snckwf/usb-game-controller-raspberry-pico-recalbox/images/controller-pico-inside.png

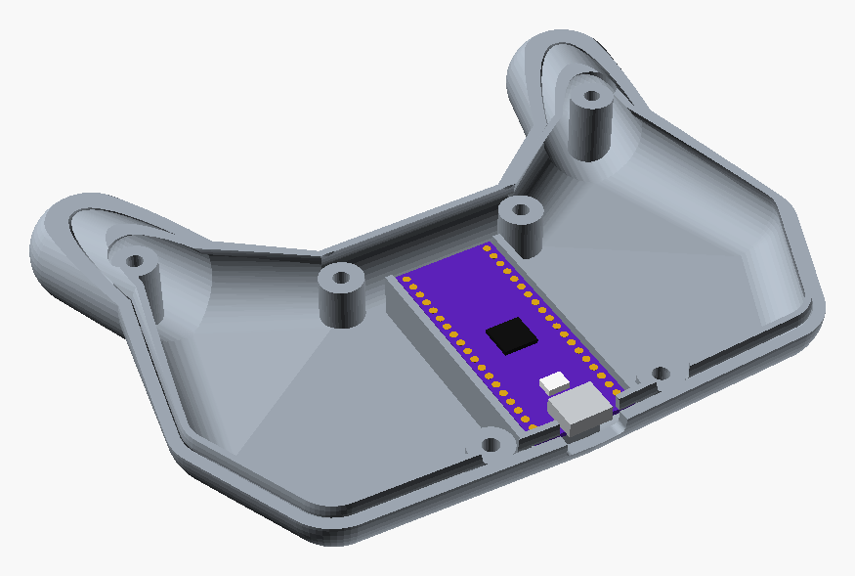
images/controller-pico-inside.png
