snckwf/usb-game-controller-raspberry-pico-recalbox/images/cover-usb-controller-pico.png

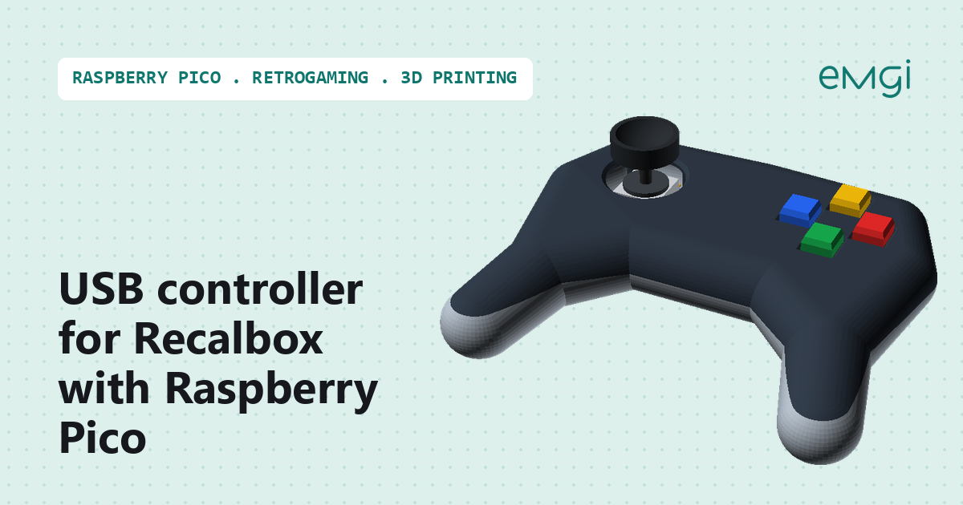
images/cover-usb-controller-pico.png
