snckwf/usb-game-controller-raspberry-pico-recalbox/images/controller-pico-parts.png

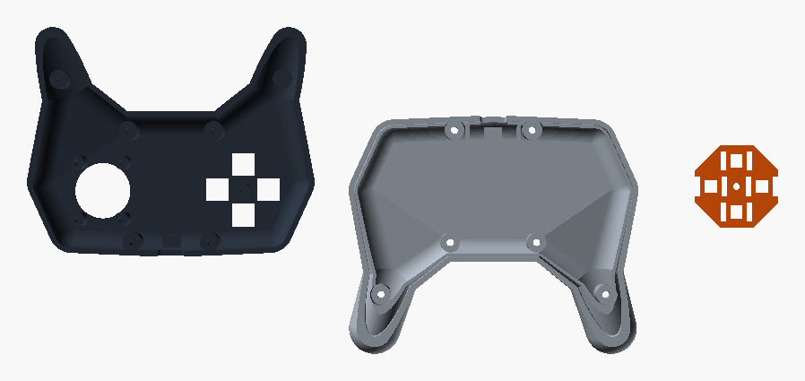
images/controller-pico-parts.png
