snckwf/usb-game-controller-raspberry-pico-recalbox/stl/controller_pico_button_plate.stl

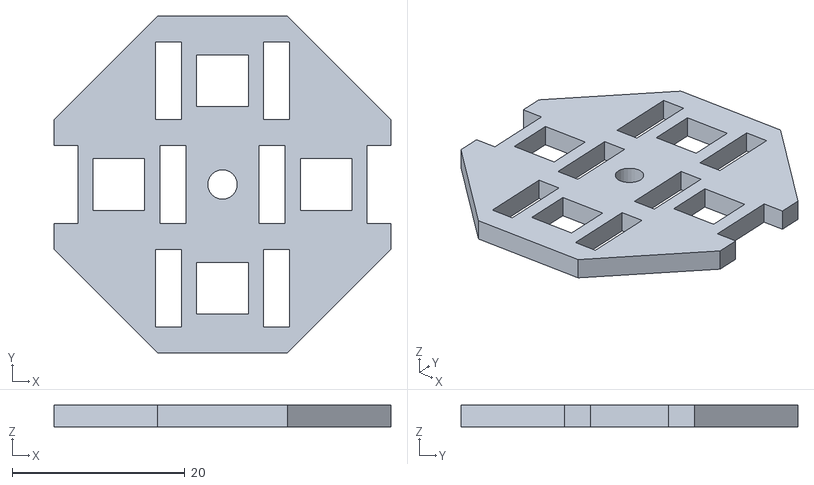
[picture p8: CAD file, 2026-10-28]
stl/controller_pico_button_plate.stl
39.0 x 39.0 x 2.50
