snckwf/usb-game-controller-raspberry-pico-recalbox/stl/controller_pico_top.stl

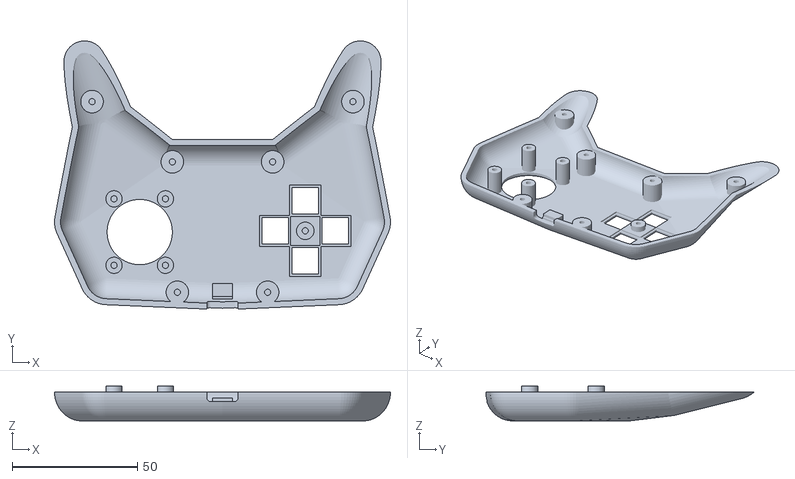
[picture p9: CAD file, 2026-10-28]
stl/controller_pico_top.stl
134.0 x 106.9 x 13.9
