snckwf/usb-game-controller-raspberry-pico-recalbox/stl/controller_pico_bottom.stl

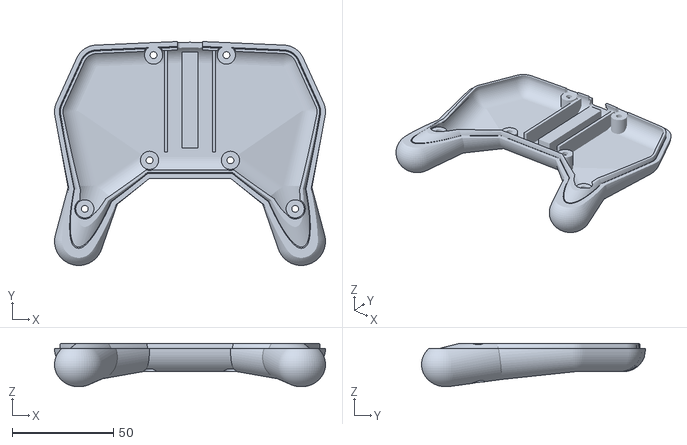
[picture p10: CAD file, 2026-10-28]
stl/controller_pico_bottom.stl
134.0 x 110.7 x 21.5
