snckwf/usb-game-controller-raspberry-pico-recalbox/docs/assembly_guide.html

Assembly and wiring guide

# Slim USB controller with Raspberry Pico

A KY-023 joystick on the left, four 12×12 buttons on the right and a Raspberry Pi Pico inside a slim 23 mm shell, with the long grips of 90s gamepads. It connects with a USB cable and is recognised as a standard gamepad by PCs, Recalbox, RetroPie, Batocera and Android, without drivers.

Assembled controller

Controller seen from the side: slim body

## Bill of materials

### Electronics

Qty | Component | Notes
1 | Raspberry Pi Pico RP2040, TZT clone with USB-C | 21 × 51 mm, 40 pins like the original Pico, no headers soldered. The original Pico with micro-USB also works
1 | KY-023 analogue joystick module | With the stick cap
4 | 12×12×7.3 tactile button with 10×10 square cap | Green, red, blue and yellow caps
1 | USB-C data cable (not charge-only) | USB-A → USB-C for the Recalbox Raspberry Pi and for the PC; 1.5–2 m long

### Screws

Qty | Component | Where
4 | M3×12 cheese-head screw | Closing the body, from below (two at the back, two at the front)
2 | M3×8 cheese-head screw | Closing in the grips, from below
4 | M3×6 button-head screw | Joystick
1 | M3×6 button-head screw | Button plate

### Consumables

Qty | Material | Notes
~90 g | PLA or PETG filament | Three printed parts, supports included
~1.5 m | 0.14–0.25 mm² flexible wire | Ideally in 7 colours (see the wiring table)
~10 cm | 1.5–2 mm heat-shrink tubing | On the joystick solder joints
— | Solder, hot glue (optional) | The glue holds the wires and the Pico in its cradle

### Tools

Fine-tip soldering iron, wire stripper, side cutters | Phillips screwdriver or hex key for the M3 screws
2.5 mm drill bit to clean up the pilot holes | Cutter or deburring tool for the supports

## Printed parts

The three parts in print orientation

From the left: top shell (upside down, as it goes on the bed), bottom shell, button plate.

Part | File | Orientation | Supports
Top shell | controller_pico_top.stl | Upside down, control face on the bed (already oriented in the file) | Tree supports, from the bed only, under the grips
Bottom shell | controller_pico_bottom.stl | As is, opening facing up | Tree supports, from the bed only: it rests on the tips of the grips
Button plate | controller_pico_button_plate.stl | Flat | None

PLA or PETG, 0.2 mm layers, 3 perimeters, 20% infill. Footprint 134 × 111 mm, 23 mm thick in the middle and 33 mm at the grip tips: it fits all Kobra printers and the i3 Mega S. Before printing, measure the hole spacing of your KY-023 (joy_fori, 20.5 × 26.5), the height of the metal bracket (joy_alt, 11.5), the thickness of the Pico board (pm_sp, 1.0) and the height of the USB-C socket (usb_h, 3.2), and correct the parameters in controller_pico.scad if needed.

## Wiring

Wiring diagram. Orange = 3.3 V, black = GND, the other colours are signals, the same as in the table below.

Component | Pin | Pico | Suggested wire
KY-023 joystick | GND | AGND (pin 33) | black
| +5V | 3V3(OUT) (pin 36) | orange
| VRx | GP26 (pin 31) | olive green
| VRy | GP27 (pin 32) | teal
| SW (click = L3 / FUNCTION) | GP6 (pin 9) | purple
Button A (bottom) | pin 1 | GP2 (pin 4) | green
Button B (right) | pin 1 | GP3 (pin 5) | red
Button X (left) | pin 1 | GP4 (pin 6) | blue
Button Y (top) | pin 1 | GP5 (pin 7) | yellow
4 buttons | pin 4 | GND (pin 38 or another GND) | black, one wire daisy-chained from button to button

The joystick pin marked +5V must go to the Pico's 3V3(OUT), not to VBUS or VSYS: with 5 V the VRx/VRy outputs exceed the 3.3 V the inputs can handle.

Pin numbers count from 1 (top left, next to the USB socket) going down the left side to 20, then back up the right side from 21 to 40. The joystick goes to the analogue ground AGND (pin 33) for less noise on the axes; the buttons to any GND (pins 3, 8, 13, 18, 23, 28, 38).

On 12×12 buttons the pins on the same side are already connected together: if a button always reads as pressed, you used two pins on the same side. Always take two diagonally opposite pins (1 and 4).

## Steps

The three parts fresh off the printer

STEP 1

### Prepare the parts

cutter2.5 mm drill bit

1. Remove the supports from the grips and clean the centring lip of the bottom shell.
2. Clean up the post pilot holes with the 2.5 mm bit (joystick, plate and the 6 closing posts).
3. Dry fit: the button caps must slide in the square holes without forcing, and the two shells must close without steps.

Joystick mounted under the top shell

Top shell upside down: the board rests on the 4 posts

STEP 2

### Solder the wires and mount the joystick

KY-0234 × M3×65 wires, 15 cm

1. Solder 5 wires, 15 cm long, to the joystick, directly onto the 90° pins (shorten them to 3–4 mm): Dupont connectors do not fit. Slide heat-shrink over each joint.
2. Place the top shell upside down on the bench. Push the stick through the 26 mm hole on the left and rest the board on the 4 posts, with the connector towards the back.
3. Drive in the M3×6 screws without overtightening: the plastic taps itself.
4. Move the stick in every direction: it must not touch the edge of the hole.

Buttons and plate mounted

Buttons in their seats, orange plate on top, screw in the middle

STEP 3

### Buttons and plate

4 buttons 12×12plate1 × M3×6

1. Fit the caps on the buttons: yellow Y at the top, red B on the right, blue X on the left, green A at the bottom.
2. Solder the signal wire to pin 1 of each button and the ground chain to pin 4 (diagonally opposite).
3. Insert the buttons from the inside: the cap comes out of the square hole, the body goes into the 12.4 mm seat.
4. Lay the plate on top: its legs go into the slots and the wires come out of the central holes.
5. Fix it with the M3×6 screw in the central post and check that all 4 buttons click.

Pico in the cradle of the bottom shell

The Pico in its cradle, USB-C socket in the rear window

STEP 4

### Upload the firmware and mount the Pico

Arduino IDERaspberry Pi PicoBOOTSEL

1. In the Boards Manager install Raspberry Pi Pico/RP2040/RP2350 by Earle F. Philhower. No libraries needed: the USB gamepad is included.
2. Before soldering, hold the Pico's BOOTSEL button while plugging in the cable: it shows up as the RPI-RP2 drive.
3. Open controller_pico.ino, choose the Raspberry Pi Pico board and UF2_Board as the port, then Upload.
4. Place the Pico in the cradle of the bottom shell, components facing up, with the USB-C socket in the rear window.
5. Solder the wires into the pin holes from the component side, following the wiring table. Leave them long enough to open the shells like a book.
6. Optional: a dab of hot glue at the bottom of the cradle. The socket is held anyway by the tooth on the top shell.

Later uploads do not need BOOTSEL: the IDE resets the Pico by itself over the USB port, even with the controller closed.

STEP 5

### Test with the shells open

joy.cplserial monitor

1. Plug in the USB cable without touching the stick: at start-up the firmware measures the joystick centre and the Pico LED blinks twice. The LED lights up while you press a button.
2. On Windows press Win+R, type joy.cpl and open the controller Properties: check the 2 axes, the d-pad (POV) and the buttons.
3. If an axis is reversed or swapped, change INVERT_X, INVERT_Y or SWAP_XY at the top of the sketch and upload again.
4. To see the raw values open the serial monitor and send d.

Closing the two shells

The top shell drops onto the lip, the 6 screws go in from below

STEP 6

### Close the controller

4 × M3×122 × M3×8

1. Route the wires away from the stick and the plate: no wire must lie under the joystick board.
2. Rest the top shell on the centring lip of the bottom shell.
3. From below, drive the 4 M3×12 screws into the body (two at the back, two at the front) and the 2 M3×8 into the grips: the shell is lower there and a long screw would come through the surface.
4. Tighten crosswise without forcing: if the shells do not close, a wire is pinched.

Back of the controller with the USB socket

The USB-C socket in the middle of the back

STEP 7

### Configure and play

RecalboxPC

With only 4 buttons, Start and Select are obtained by holding the joystick click (FUNCTION key):

Combination | Function
L3 + Y | START
L3 + X | SELECT (Recalbox hotkey)
L3 + A | L1
L3 + B | R1
L3 pressed and released | L3 click
L3 held on its own for 5 seconds | recalibrates the stick centre

1. Recalbox: plug the controller into a USB port of the Raspberry Pi. From the menu (Start) › Controller settings › Configure a controller, follow the prompts: for the d-pad move the stick (the firmware also sends a digital d-pad derived from the stick), for Start, Select and Hotkey use the combinations above.
2. PC: Steam and most games see it as a generic gamepad; in Steam configure it once from Settings › Controller.
3. If a game does not like the digital d-pad together with the stick, set DPAD_FROM_STICK to 0 in the sketch.

## Troubleshooting

Symptom | Likely cause | Fix
The PC does not see the controller | Charge-only USB-C cable | Try a data cable: with a good cable the Pico shows up as a gamepad and as a COM port
The IDE cannot find the upload port | Firmware stuck or first upload | Unplug the cable, hold BOOTSEL, plug it back in and upload to the UF2_Board port
The stick drifts by itself | Stick touched while plugging in the cable | Hold the stick click for 5 seconds, with the stick at rest
Axis reversed or swapped | Orientation of the KY-023 module | Change INVERT_* or SWAP_XY in the sketch
The stick reaches full scale halfway through its travel | Joystick powered at 5 V instead of 3.3 V | Move the module's +5V wire to the 3V3(OUT) pin
A button always reads as pressed | Wires on two pins on the same side | Move the wire to the diagonally opposite pin
The stick touches the edge of the hole | Module with a wider travel | Increase joy_foro in the .scad file and reprint the top shell
The shells do not close | Pinched wire, or the tooth above the USB-C socket presses too hard | Reopen and move the wires; if it touches the socket, measure pm_sp and usb_h, correct them and reprint the top shell

Project files: controller_pico.scad (parametric model), controller_pico_top.stl, controller_pico_bottom.stl, controller_pico_button_plate.stl, sketch controller_pico.ino and diagram wiring_diagram.svg / .png. More projects at www.emgi.it.
